j0lama/RubikSolver/cara5.jpg

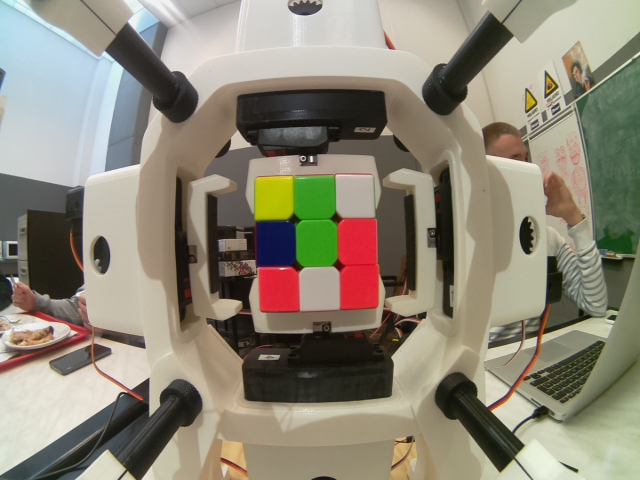
cara5.jpg
