j0lama/RubikSolver/cara6.jpg

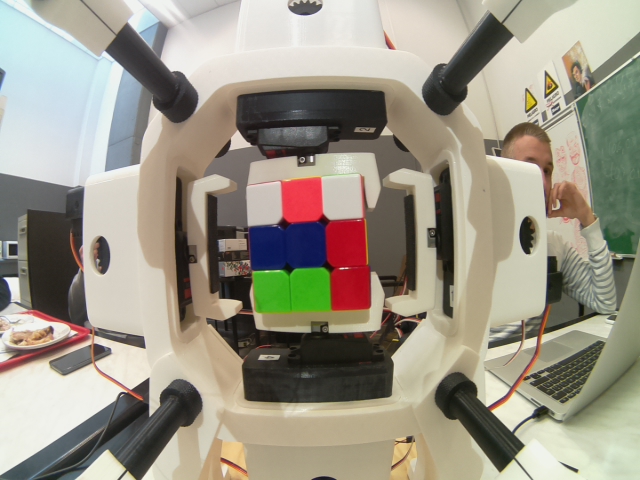
cara6.jpg
