j0lama/RubikSolver/cara1.jpg

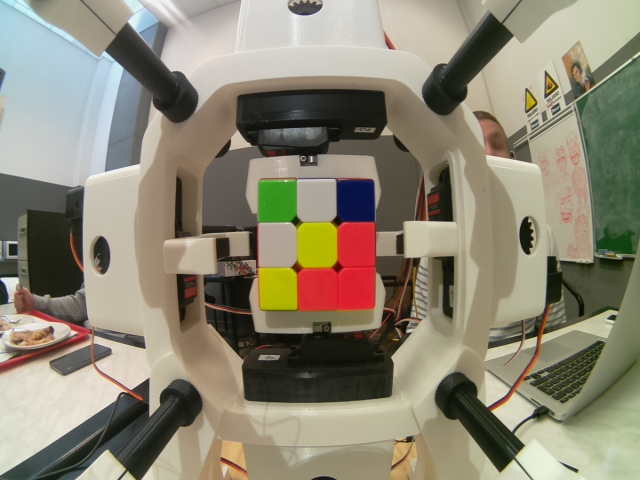
cara1.jpg
