j0lama/RubikSolver/cara2.jpg

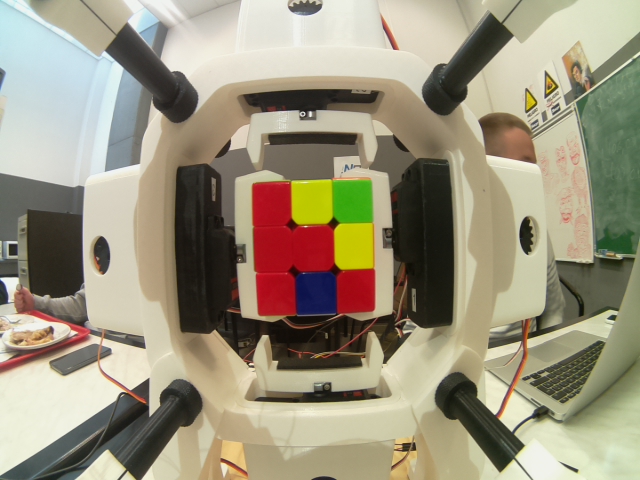
cara2.jpg
