j0lama/RubikSolver/cara3.jpg

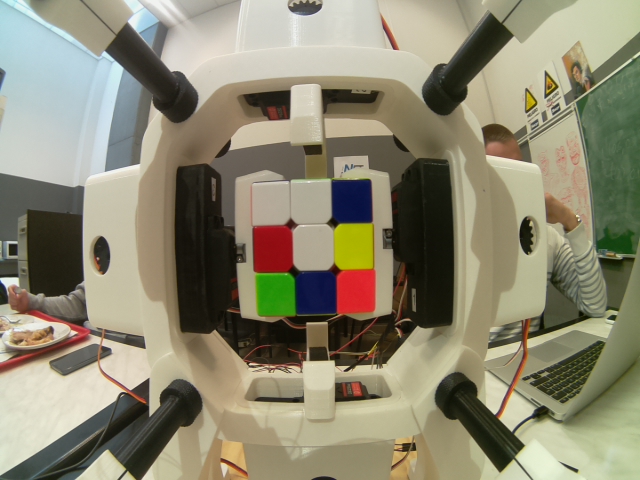
cara3.jpg
