j0lama/RubikSolver/(commit log)

2018-07-19 La lógica funciona correctamente, hay que hacer la máquina
    [demo.py]
2019-04-19 Fihcero control motores
2019-04-30 Codigo arduino subido
2019-04-30 Añadida la memoria
